elevendroids/elevendroids-kicad-libraries/template/Combiplast_Z94/meta/board.png

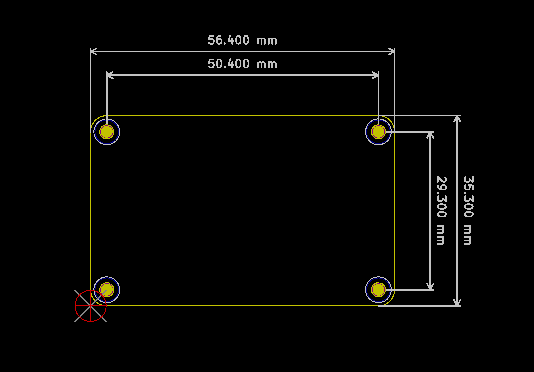
template/Combiplast_Z94/meta/board.png
