elevendroids/elevendroids-kicad-libraries/template/RaspberryPi_uHAT/meta/board.png

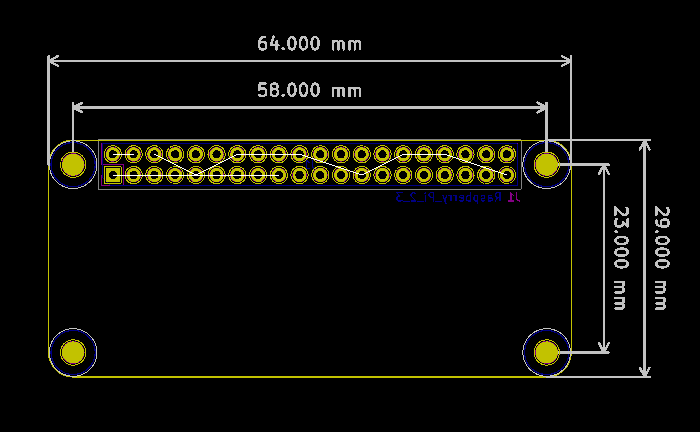
template/RaspberryPi_uHAT/meta/board.png
