elevendroids/elevendroids-kicad-libraries/(commit log)

2018-07-30 Added project templates directory
    [Combiplast_Z94.kicad_pcb, Combiplast_Z94.sch]
2018-09-05 E01-ML01S - set default footprint
2018-09-24 Added Elevendroids_74xx symbol library
    Fixed 74HC244 symbol from KiCad library:
    - Outputs set to tri-state
    - Added (P)DIP-20 to package filter
2018-12-09 Project templates for Supertronic PP42 cases
    [Supertronic_PP42_Bottom.kicad_pcb, Supertronic_PP42_Bottom.sch, Supertronic_PP42_Top.kicad_pcb, Supertronic_PP42_Top.sch]
2018-12-09 Project templates for Supertronic PP73 cases
    [Supertronic_PP73_Bottom.kicad_pcb, Supertronic_PP73_Bottom.sch, Supertronic_PP73_Top.kicad_pcb, Supertronic_PP73_Top.sch]
2018-12-09 Symbol and footprint for Hi-Link HLK-PMxx AC/DC converters
2018-12-10 E01-ML01IPX footprint
2018-12-10 Set E01-ML01* footprint filters
2018-12-11 Keystone 1028 1xAA battery holder
2018-12-11 Keystone 1028 1xAA battery holder with mounting holes
2018-12-12 E01-ML01IPX: small footprint fixes
2018-12-12 Added E01-ML01SP4 symbol and footprint, fixed validation errors
2018-12-15 Updated templates
    Added mounting holes on schematics, dimensions and re-adjusted board
    sizes
    [Combiplast_Z94.kicad_pcb, Combiplast_Z94.sch, Supertronic_PP42_Bottom.kicad_pcb, Supertronic_PP42_Bottom.sch, Supertronic_PP42_Top.kicad_pcb, Supertronic_PP42_Top.sch, Supertronic_PP73_Bottom.kicad_pcb, Supertronic_PP73_Bottom.sch]
2018-12-15 Raspberry Pi uHAT template
    [RaspberryPi_uHAT.kicad_pcb, RaspberryPi_uHAT.sch]
2018-12-15 Combiplast Z94: Added board image to the meta info
2018-12-15 Added 14250 (1/2 AA) battery with leads
2020-07-23 Added symbols for STM32L010 MCUs
2020-08-17 Added symbols for PCA9634 LED driver
2020-10-22 [Symbols][Footprints] Added E01-ML01SP2 RF module
2020-11-10 Added STM32G0x0 and STM32G4x1 MCUs - SO-8, TSSOP-20 and LQFP-32 only
2020-11-10 [Symbols] STM32G4x1 - fixed VSS pins
2020-11-10 [Symbols] Added STM32G0x0 in LQFP-48 package
2020-11-10 [Symbols] Fixed STM32G0x0 pin types
2020-11-11 [Symbols] Added STM32G070RBTx
2020-11-11 [Symbols] STM32G - small symbol tweaks
    - added SWDIO and SWCLK labels
    - adjusted symbols width
2020-11-11 [Symbols] Tweaked STM32L010 symbols
    - added SWD labels
    - added OSC32 labels
2020-11-11 [Symbols] Added most of STM32G0x1 symbols - except WLCSP and BGA variants
2020-11-11 [Symbols] Split STM32 symbols into separate, per-family libs
2021-04-06 [Symbols] Added more STM32G0 and STM32G4 variants
2021-04-07 [Symbols] Fixed compliance with KiCad Library Conventions
2021-04-07 [Footprints] Fixed compliance with KiCad Library Conventions
2021-04-11 [Footprints] C&K JS202011SCQN SMD DPDT switch
2021-04-11 [Footprints] C&K JS202011CQN THT DPDT switch
2021-04-11 [Footprints] TI RLL S-PVQFN-N24 package
2021-04-11 [Symbols] Added previously missing RLL footprint to MSP430 symbols
2021-04-11 [Footprints] Fixed pads numbering in Texas RLL S-PVQFN-N24
2021-11-06 [Footprints][Symbols] MSP430FR2000 and RLL QFN package fixups
    - Connected the thermal pad (pin 25) of the RLL package to GND
    - Added new variant of the TI RLL package with thermal vias
2021-12-29 Kicad 6.0 symbols
2022-04-22 AC/DC converter footprints cleanup
2022-04-24 Removed legacy KiCad symbol library files
2022-05-16 MCCOG21605B footprint - adjusted position of the backlight pins
